AdJakub/Tznami-pw1.3/images/PW67_Case_Preview.png

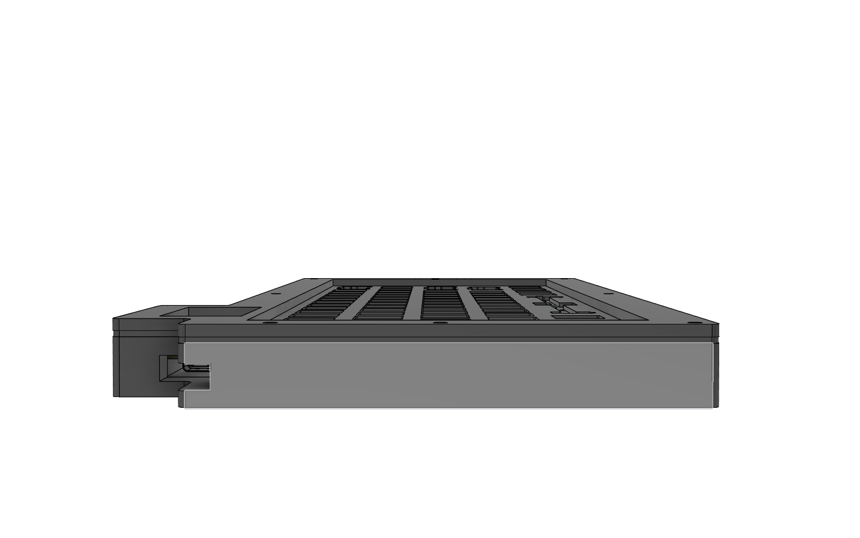
images/PW67_Case_Preview.png
