AdJakub/Tznami-pw1.3/images/PW67_Lower_Shell_cable_channel.png

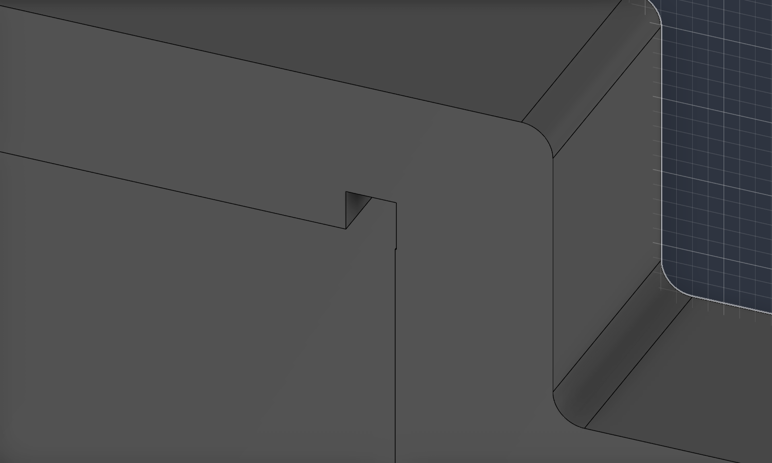
images/PW67_Lower_Shell_cable_channel.png
