AdJakub/Tznami-pw1.3/BOM.md

# Keeb pw1.3 – bill of materials

<!-- Generated by Half Life from project cmuwsyxfk0ak601os849koecs. Edits here are overwritten on the next sync. -->
<!-- Generated: 2026-10-11T23:20:39.257Z -->

> [!NOTE]
> This parts list is mirrored from [Half Life](https://halflife.hackclub.com). Editing it here will not change the platform's copy, and the next sync overwrites this file.

| Week | Tier | Parts funding |
| --- | --- | --- |
| Week 1 | Tier 3 | $100.00 |

| Part | What it's for | Qty | Unit | Total | Vendor |
| --- | --- | --- | --- | --- | --- |
| [Adafruit KB2040](https://kamami.pl/plytki-bazowe-z-rp2040-i-rp235x/588698-adafruit-kb2040-plytka-z-mikrokontrolerem-rp2040-adafruit-5302-5906623430918.html) | MCU | 1 | $13.02 | $13.02 | [Kamami](https://kamami.pl/plytki-bazowe-z-rp2040-i-rp235x/588698-adafruit-kb2040-plytka-z-mikrokontrolerem-rp2040-adafruit-5302-5906623430918.html) |
| [Keyboard PCB](https://cart.jlcpcb.com/shopcart/cart) | printed PCB for the keyboard (cost for jlcpcb minimum order) | 1 | $21.90 | $21.90 | [JLCPCB](https://cart.jlcpcb.com/shopcart/cart) |
| [OLED 0,91″ 128x32px I2C](https://sklep.msalamon.pl/produkt/wyswietlacz-oled-091-i2c-bialy/) | displaying stuff! | 1 | $3.83 | $3.83 | [msalamon](https://sklep.msalamon.pl/produkt/wyswietlacz-oled-091-i2c-bialy/) |
| [STEMMA QT JST SH 4-Pin Cable](https://kamami.pl/przewody-jst/1179393-stemma-qt-jst-sh-4-pin-cable-przewod-stemma-qt-100mm-4210-5906623431175.html) | Connect oled to MCU | 1 | $1.38 | $1.38 | [Kamami](https://kamami.pl/przewody-jst/1179393-stemma-qt-jst-sh-4-pin-cable-przewod-stemma-qt-100mm-4210-5906623431175.html) |
| [1N4148 Diode 10 pack](https://kamami.pl/diody-schottky/1187768-dioda-impulsowa-1n4148-tht-500mw-75v-10-szt-5906623484720.html) | anti ghosting in keyboard | 7 | $0.64 | $4.48 | [Kamami](https://kamami.pl/diody-schottky/1187768-dioda-impulsowa-1n4148-tht-500mw-75v-10-szt-5906623484720.html) |
| [Gateron milky pro yellow 10 pack](https://keyspace.store/products/switche-gateron-milky-pro-yellow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) | switches for keyboard! | 7 | $3.55 | $24.85 | [keyspace.store](https://keyspace.store/products/switche-gateron-milky-pro-yellow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) |
| **Parts subtotal** | — | — | — | **$69.46** | — |
| **Tax & shipping** | — | — | — | **$27.77** | — |
| **Total** | — | — | — | **$97.23** | — |

$2.77 left of the tier's funding.
