AdJakub/Tznami-pw1.3/cad/print/PW1.3.step

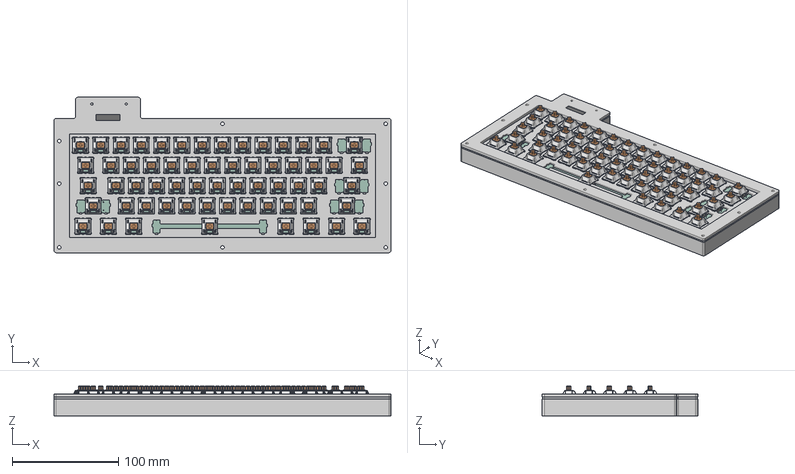
[picture p5: CAD file, 2026-10-11]
cad/print/PW1.3.step
316.5 x 146.1 x 27.9 mm
