AdJakub/Tznami-pw1.3/hardware/5302 KB2040.step

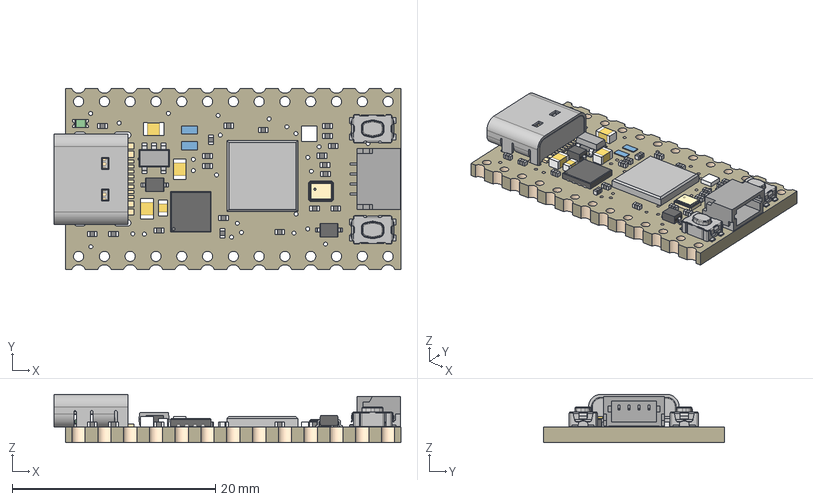
[picture p6: CAD file, 2026-10-11]
hardware/5302 KB2040.step
34.2 x 17.8 x 4.77 mm
Board
10µF x 2
AP2112K-3.3
KMR2 x 2
10K x 20
WS2812B_SK6805_1515
NSR0320 x 2
8MB QSPI Flash
1uF x 2
RP2040_QFN56
12MHZ
1uF_1
USB TYPE C
FUSE
STEMMA_I2C_QTSKINNY
GREEN
