AdJakub/Tznami-pw1.3/cad/print/PW67_Upper_Frame_OLED_print.stl

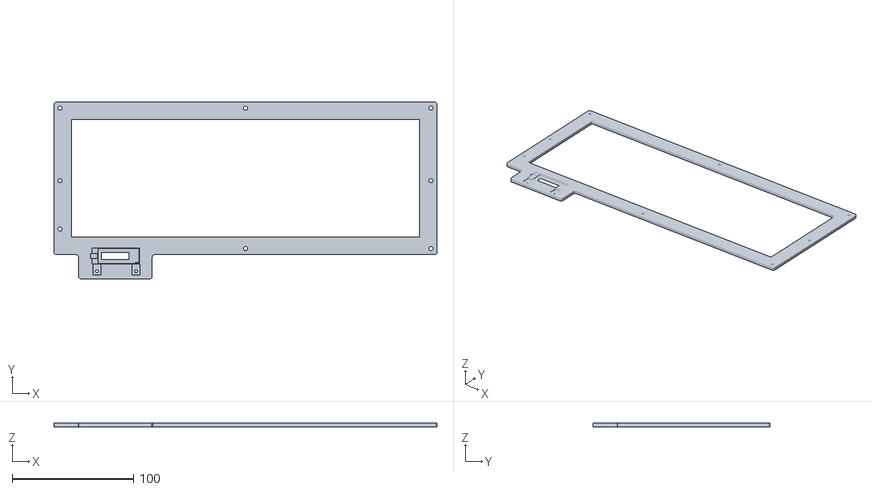
[picture p7: CAD file, 2026-10-11]
cad/print/PW67_Upper_Frame_OLED_print.stl
316.5 x 146.1 x 3.00
