AdJakub/Tznami-pw1.3/cad/print/PW67_Lower_Shell_OLED_print.stl

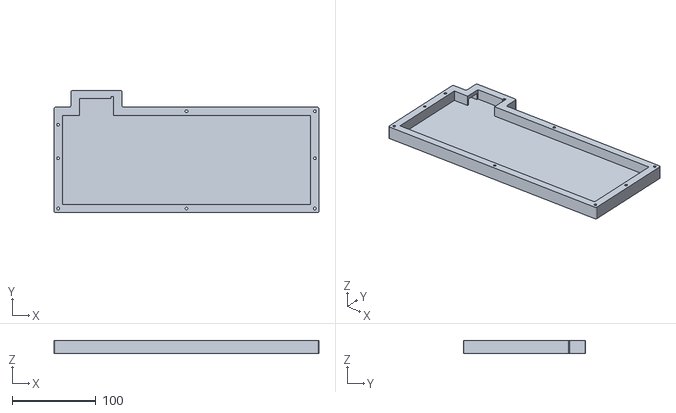
[picture p8: CAD file, 2026-10-11]
cad/print/PW67_Lower_Shell_OLED_print.stl
316.5 x 146.1 x 16.0
