AdJakub/Tznami-pw1.3/cad/print/PW67_OLED_Clip_A_print.stl

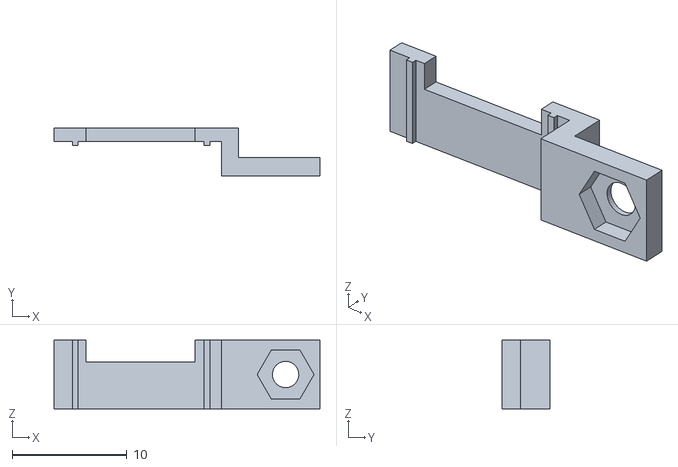
[picture p10: CAD file, 2026-10-11]
cad/print/PW67_OLED_Clip_A_print.stl
23.2 x 4.20 x 6.00
