AdJakub/Tznami-pw1.3/(list of files, cad)

Other CAD files:
cad/PW67_Lower_Shell_OLED.f3d
cad/PW67_OLED_Assembly.f3d
cad/PW67_OLED_Clip_A.f3d
cad/PW67_OLED_Clip_B.f3d
cad/PW67_Switch_Plate.f3d
cad/PW67_Upper_Frame_OLED.f3d
