AdJakub/Tznami-pw1.3/(list of files, drawings)

Other design files:
docs/schematic-controller-nets.json
docs/validation/schematic-parity-drc.json
