AdJakub/Tznami-pw1.3/JOURNAL.md

# Keeb pw1.3 – devlog

<!-- Generated by Half Life from project cmuwsyxfk0ak601os849koecs. Edits here are overwritten on the next sync. -->
<!-- Generated: 2026-10-12T00:08:15.346Z -->

> [!NOTE]
> This devlog is mirrored from [Half Life](https://halflife.hackclub.com). Editing it here will not change the platform's copy, and the next sync overwrites this file.

| Week | Tier | Hours logged | Entries |
| --- | --- | --- | --- |
| Week 1 | Tier 3 | 22h | 5 |

## Contents

1. [2026-10-06 – Started working on a standard 60% keyboard, It will use a raspberry pi pico for it's microcontroller. Spend the first time getting used to kicad again, as i haven't worked on it since blueprint. Set u](#2026-10-06-started-working-on-a-standard-60-keyboard-it-will)
2. [2026-10-07 – Oct. 7th. Started by picking out the exact MCU i want to use, i ultimately landed on kb2040 because it met most of my requirements, is available relatively cheap in my country, and has usb C. I rework](#2026-10-07-oct-7th-started-by-picking-out-the-exact-mcu-i-wa)
3. [2026-10-08 – Today i decided to add an oled screen. I decided to put the MCU on the back side of the pcb, and oled on top side. it will connect through the QT connector. I had to redo all the routing and everythin](#2026-10-08-today-i-decided-to-add-an-oled-screen-i-decided-t)
4. [2026-10-11 – Time to start working on the case! need to finish it all today, busy day ahead.](#2026-10-11-time-to-start-working-on-the-case-need-to-finish-)
5. [2026-10-11 – Started working at 9PM Polish time, 11 october. Finishing now at 2 am 12th october. My sleep schedule will not like this....](#2026-10-11-started-working-at-9pm-polish-time-11-october-fin)

## Design

### 2026-10-06 – Started working on a standard 60% keyboard, It will use a raspberry pi pico for it's microcontroller. Spend the first time getting used to kicad again, as i haven't worked on it since blueprint. Set u

**2h**

Started working on a standard 60% keyboard, It will use a raspberry pi pico for it's microcontroller. Spend the first time getting used to kicad again, as i haven't worked on it since blueprint. Set up kicad libraries, drew out the schematic and wired the PCB.

obraz

obraz

I am yet to connected the MCU either in the schematic or the pcb, i'm leaving that for tommorow.

### 2026-10-07 – Oct. 7th. Started by picking out the exact MCU i want to use, i ultimately landed on kb2040 because it met most of my requirements, is available relatively cheap in my country, and has usb C. I rework

**4h**

Oct. 7th. Started by picking out the exact MCU i want to use, i ultimately landed on kb2040 because it met most of my requirements, is available relatively cheap in my country, and has usb C. I reworked the matrix to fit the 18 GPIO pins of the kb2040

obraz

Then i played around with multiple ideas on where to put the MCU on the board. In the end, i landed with this design of a pocket in the top edge. I feel this will be the most comfortable for me to plug my cable in.

obraz

Then, i wanted to start routing! But... kicad started showing me this error.

obraz

I was completly lost! I googled around, and i found out the file can be corrupted. I checked the file and it had the correct size. I was truly lost, and then i thought to check the file with an online hex editor. It showed me the cause. Even though the file was still the old size, it was filled with zeroes.

obraz

I recovered from kicad history snapshots afterwise. Routing also took me a good while. I haven't done it in a while, and i tried my absolute hardest for it to not be a mess.

obraz

For tomorrow, i'm thinking of adding a small oled screen. After that, i'll get started working on the case-cad and firmware, so i'm ready for the building part!

I started around 5 PM polish time today, and adjusting for food breaks and all, i think it's fair to say i worked for 4 hours on this session.

### 2026-10-08 – Today i decided to add an oled screen. I decided to put the MCU on the back side of the pcb, and oled on top side. it will connect through the QT connector. I had to redo all the routing and everythin

**3h**

Today i decided to add an oled screen. I decided to put the MCU on the back side of the pcb, and oled on top side. it will connect through the QT connector. I had to redo all the routing and everything.

obraz

obraz

(its not connected to anything becuase it will be connected through the STEMMA QT connector)

I still need to figure out mounting the  OLED and designing the case.

Most of today was routing. So i dont have  a lot of images. have the 3d renders!

obraz

obraz

### 2026-10-11 – Time to start working on the case! need to finish it all today, busy day ahead.

**8h**

Time to start working on the case! need to finish it all today, busy day ahead.
I upload the step file to fusion 360, and i immediatly notice the diodes are underneath the 5 pin switch plastic thingies. I'll move them later to avoid a collison

obraz

obraz

I locked in on the case, forgot to take much screenshots of the process, but i think i'd lose my focus. After making the basic sandwich-mount case with flang and everything, i worked on the USB opening. it's kind of quirky, but i customized it to fit my personal desk setup the most.

obraz

obraz
later today, before i get to firmware, ill add a debug window here for the mcu

obraz

Then, i uploaded the remaining 3d models to kicad. Conflict confirmed.

obraz

changed positioning and re-routed to clear the conflict

obraz

i also need to figure out a way to mount the OLED module. right now theres a conflict with the MCU, but ill be connecting it through the STEMMA QT either ways. I'll look into adding an oled mount to the case!

obraz

### 2026-10-11 – Started working at 9PM Polish time, 11 october. Finishing now at 2 am 12th october. My sleep schedule will not like this....

**5h**

Started working at 9PM Polish time, 11 october. Finishing now at 2 am 12th october. My sleep schedule will not like this....

Finished modeling the OLED mount,

obraz

Also enclosed the screen

obraz

Had to set up the QMK on this machine

obraz

obraz

I finished setting up the firmware files and started compiling

obraz

oops

obraz

had to make it lowercase

obraz

obraz

It succesfuly compiled, i then set up the github repo and the BOM. Had to cut down on some parts and increase tier, cant really find anything cheaper to fully fund this project.
